LPAE/artigos/eolico_2024/Peças 3D/Engrenagem_Grande.stl

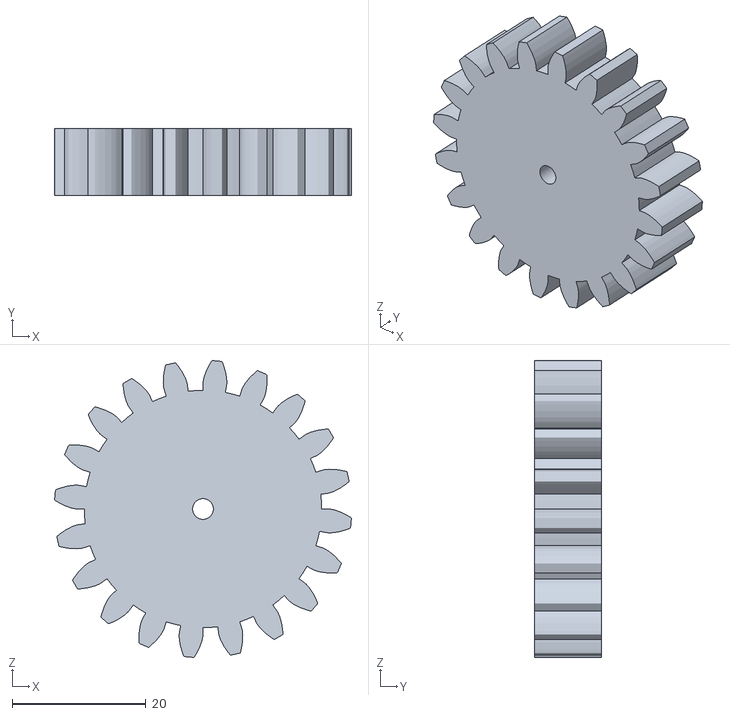
[picture p16: CAD file, 2024-05-15]
eolico_2024/Peças 3D/Engrenagem_Grande.stl
44.4 x 10.0 x 44.4
