LPAE/artigos/eolico_2024/Peças 3D/Peças Modificadas/BaseOca3.2.stl

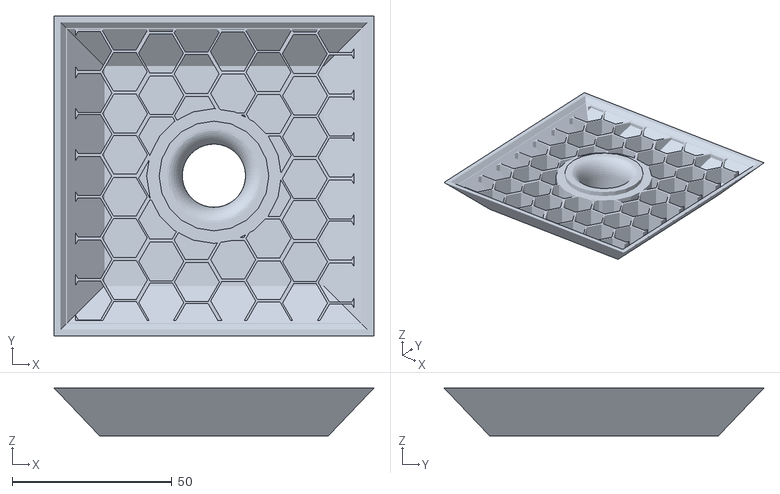
[picture p17: CAD file, 2024-05-15]
eolico_2024/Peças 3D/Peças Modificadas/BaseOca3.2.stl
100.0 x 100.0 x 15.0
