LPAE/artigos/eolico_2024/Peças 3D/Peças Modificadas/BaseSolida2.0.stl

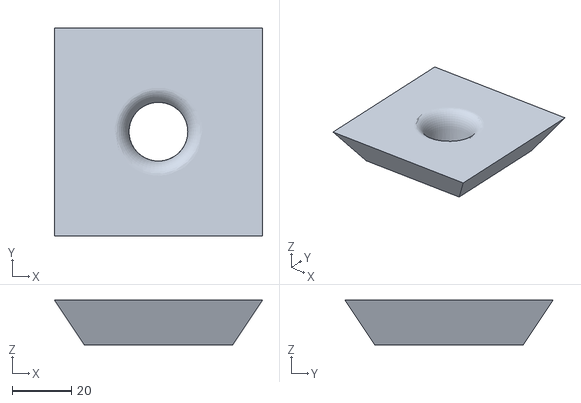
[picture p18: CAD file, 2024-05-15]
eolico_2024/Peças 3D/Peças Modificadas/BaseSolida2.0.stl
70.0 x 70.0 x 15.0
