LPAE/artigos/eolico_2024/Peças 3D/Suporte_Motor.stl

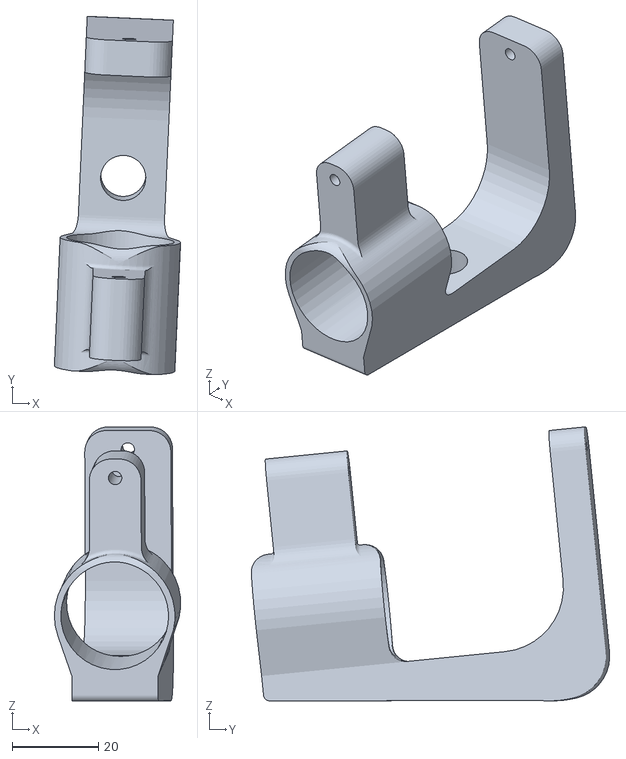
[picture p19: CAD file, 2024-05-15]
eolico_2024/Peças 3D/Suporte_Motor.stl
29.3 x 83.1 x 63.5
