LPAE/artigos/eolico_2024/Peças 3D/Engrenagem_Pequena.stl

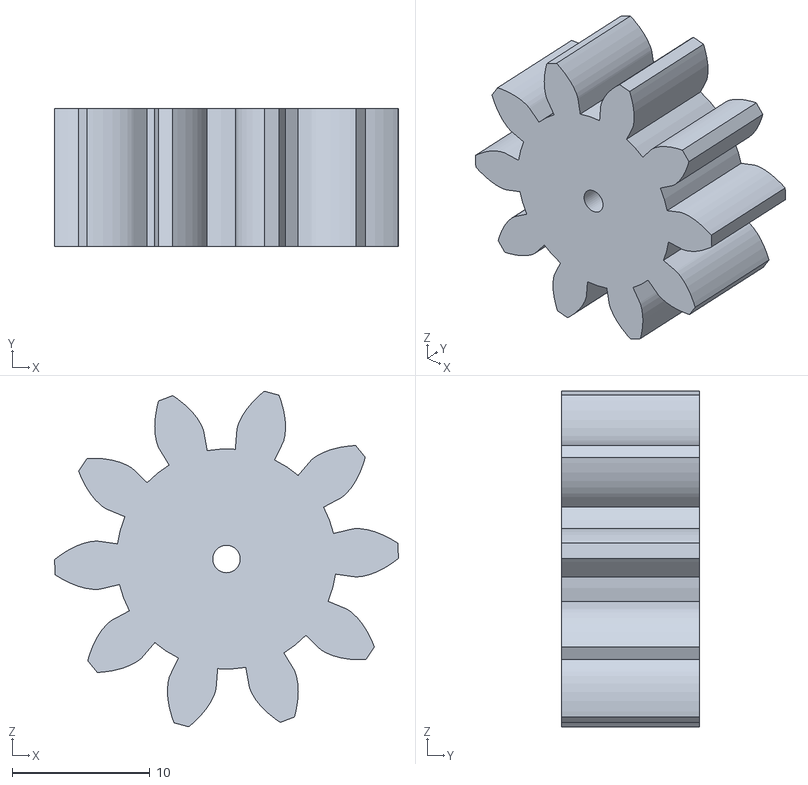
[picture p20: CAD file, 2024-05-15]
eolico_2024/Peças 3D/Engrenagem_Pequena.stl
25.0 x 10.0 x 24.4
