LPAE/artigos/eolico_2024/Peças 3D/Peças Modificadas/Turbinia3.2.stl

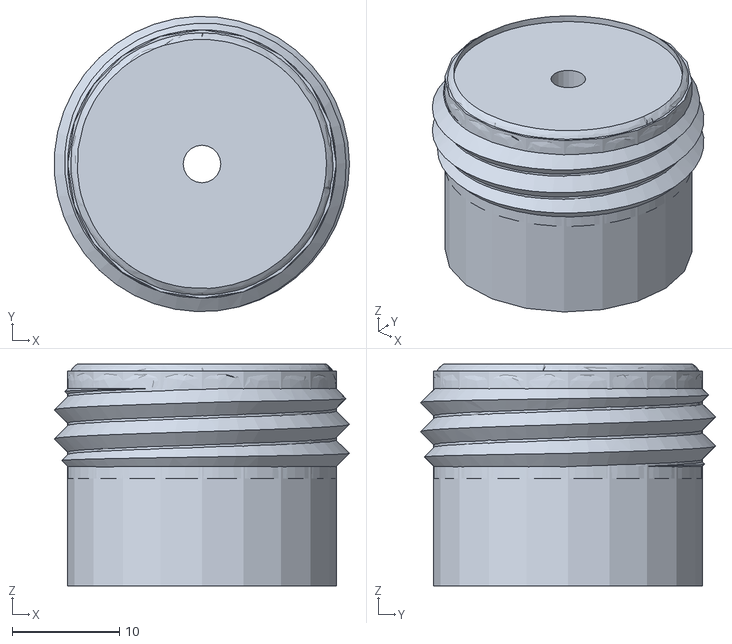
[picture p21: CAD file, 2024-05-15]
eolico_2024/Peças 3D/Peças Modificadas/Turbinia3.2.stl
27.5 x 27.5 x 20.7
