LPAE/artigos/eolico_2024/Peças 3D/Suporte_Helices.stl

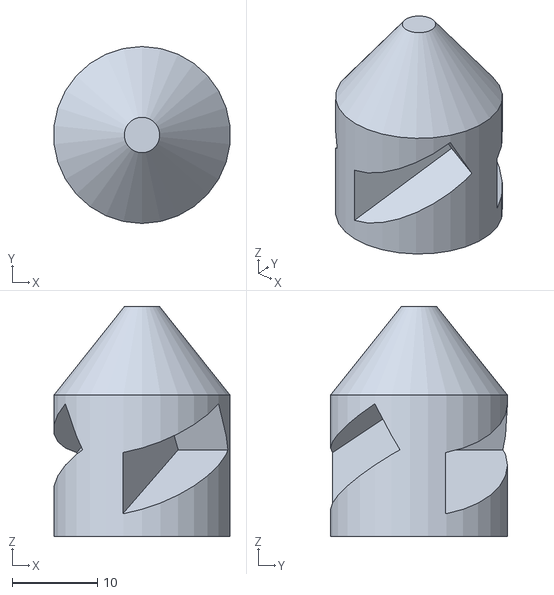
[picture p23: CAD file, 2024-05-15]
eolico_2024/Peças 3D/Suporte_Helices.stl
20.7 x 20.8 x 27.0
