LPAE/artigos/eolico_2024/Peças 3D/Base.stl

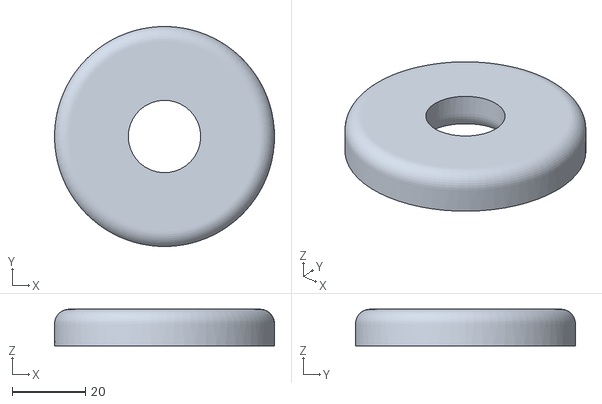
[picture p24: CAD file, 2024-05-15]
eolico_2024/Peças 3D/Base.stl
60.0 x 60.0 x 10.0
