LPAE/artigos/eolico_2024/Peças 3D/Peças Modificadas/BaseSolida1.0.stl

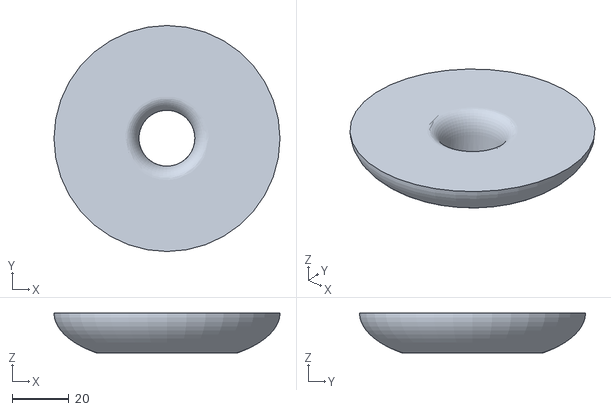
[picture p25: CAD file, 2024-05-15]
eolico_2024/Peças 3D/Peças Modificadas/BaseSolida1.0.stl
80.0 x 80.0 x 14.0
