LPAE/artigos/eolico_2024/Peças 3D/Suporte_Estrutura.stl

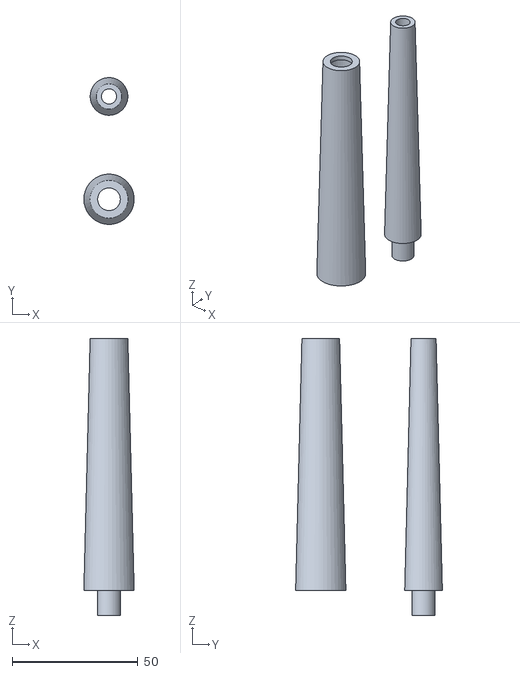
[picture p27: CAD file, 2024-05-15]
eolico_2024/Peças 3D/Suporte_Estrutura.stl
20.0 x 58.3 x 110.0
