LPAE/artigos/eolico_2024/Peças 3D/Helice.stl

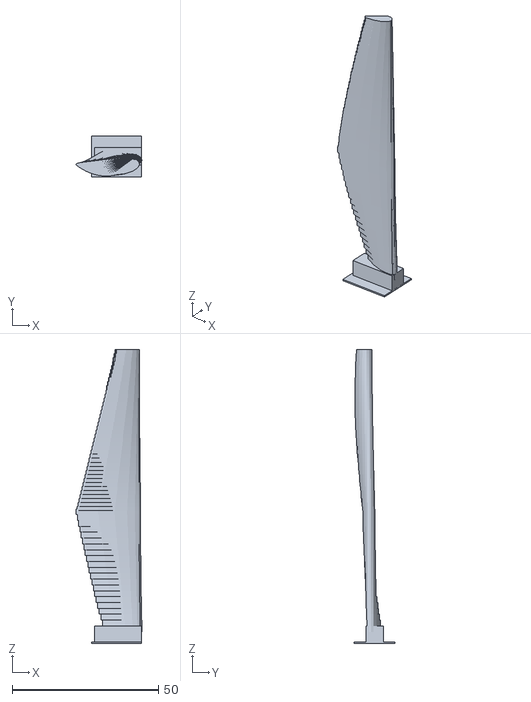
[picture p28: CAD file, 2024-05-15]
eolico_2024/Peças 3D/Helice.stl
22.5 x 14.0 x 100.4
