LPAE/artigos/eolico_2024/Peças 3D/Engrenagem_Grande_2.stl

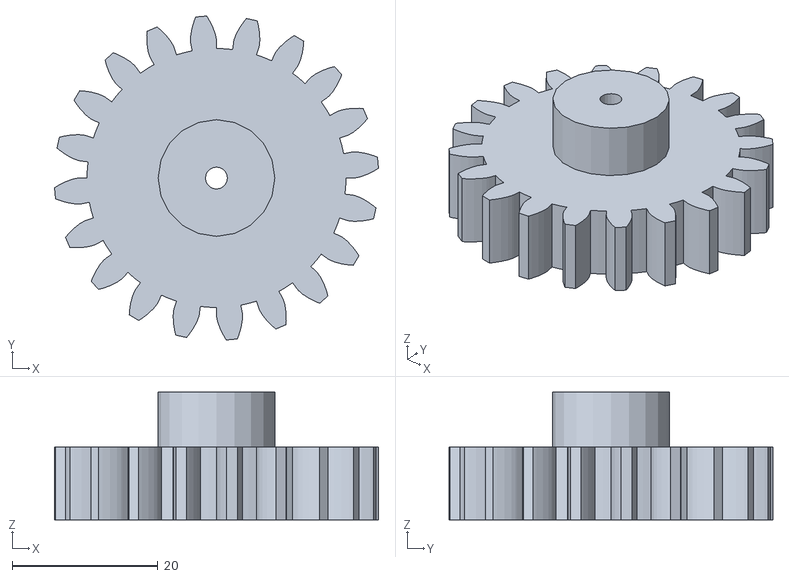
[picture p29: CAD file, 2024-05-15]
eolico_2024/Peças 3D/Engrenagem_Grande_2.stl
44.4 x 44.4 x 17.5
