LPAE/artigos/eolico_2024/Projeto Kicad/Geracao_Eolica/teste.kicad_pcb

## KiCad design eolico_2024/Projeto Kicad/Geracao_Eolica/teste.kicad_pcb (2024-05-15)

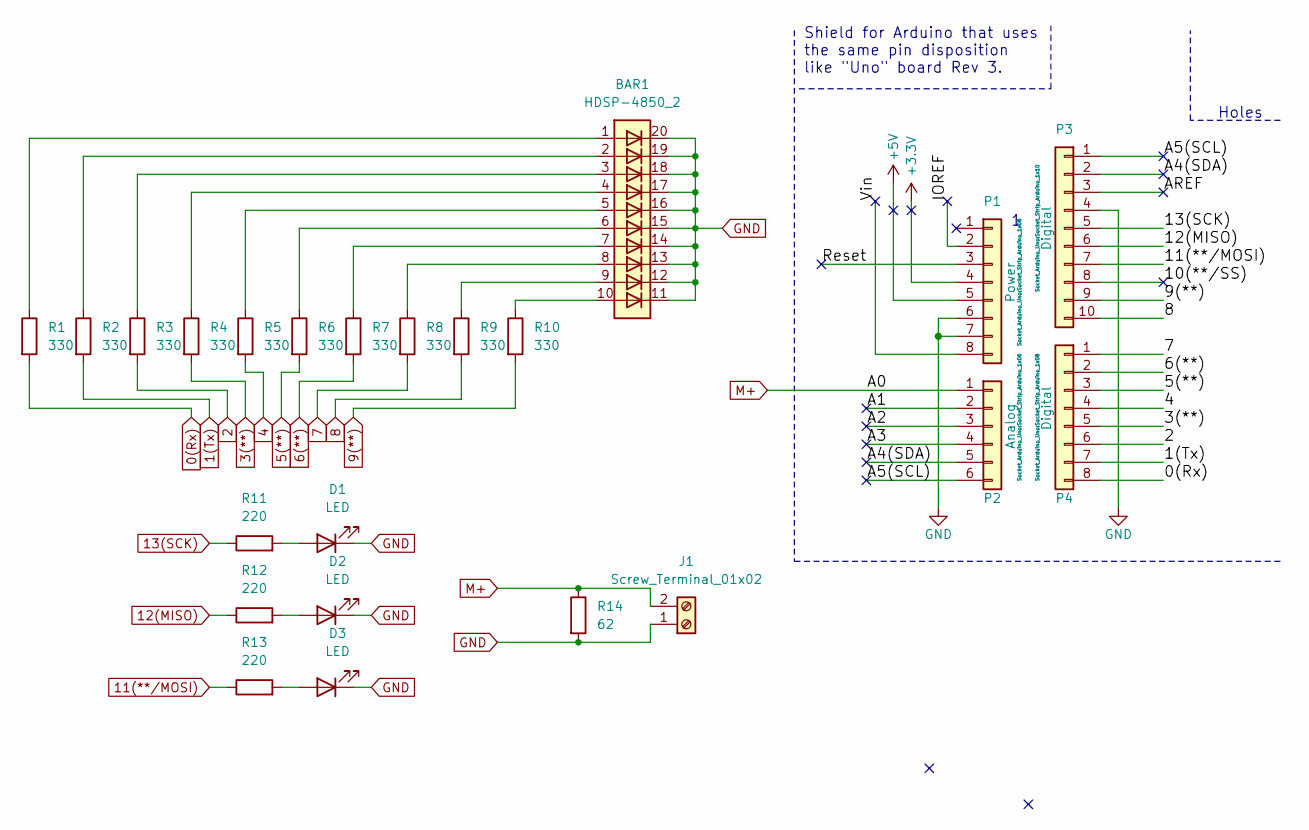
[picture p30: schematic teste.kicad_sch, Geração Eólica IFSC - IEE]

Parts:
BAR1: HDSP-4850_2; HDSP-4850
D1, D2, D3: LED; LED_D3.0mm
J1: Screw_Terminal_01x02; TerminalBlock_Phoenix_MKDS-1,5-2_1x02_P5.00mm_Horizontal
P1: Power; Socket_Strip_Arduino_1x08
P2: Analog; Socket_Strip_Arduino_1x06
P3: Digital; Socket_Strip_Arduino_1x10
P4: Digital; Socket_Strip_Arduino_1x08
R1, R2, R3, R4, R5, R6, R7, R8, R9, R10: 330; R_Axial_DIN0207_L6.3mm_D2.5mm_P10.16mm_Horizontal
R11, R12, R13: 220; R_Axial_DIN0207_L6.3mm_D2.5mm_P10.16mm_Horizontal
R14: 62; R_Axial_DIN0204_L3.6mm_D1.6mm_P7.62mm_Horizontal

Connections:
0(Rx): P4.8, R1.2
1(Tx): P4.7, R2.2
2: P4.6, R3.2
3(**): P4.5, R4.2
4: P4.4, R5.2
5(**): P4.3, R6.2
6(**): P4.2, R7.2
7: P4.1, R8.2
8: P3.10, R9.2
9(**): P3.9, R10.2
11(**/MOSI): P3.7, R13.1
12(MISO): P3.6, R12.1
13(SCK): P3.5, R11.1
+3V3: P1.4
+5V: P1.5
/10(**/SS): P3.8
/A1: P2.2
/A2: P2.3
/A3: P2.4
/A4(SDA): P2.5, P3.2
/A5(SCL): P2.6, P3.1
/AREF: P3.3
/IOREF: P1.2
/Reset: P1.3
/Vin: P1.8
GND: BAR1.11 (K), BAR1.12 (K), BAR1.13 (K), BAR1.14 (K), BAR1.15 (K), BAR1.16 (K), BAR1.17 (K), BAR1.18 (K), BAR1.19 (K), BAR1.20 (K), D1.1 (K), D2.1 (K), D3.1 (K), J1.1, P1.6, P1.7, P3.4, R14.2
M+: J1.2, P2.1, R14.1
unnamed: BAR1.1 (A), R1.1
unnamed: BAR1.2 (A), R2.1
unnamed: BAR1.3 (A), R3.1
unnamed: BAR1.4 (A), R4.1
unnamed: BAR1.5 (A), R5.1
unnamed: BAR1.6 (A), R6.1
unnamed: BAR1.7 (A), R7.1
unnamed: BAR1.8 (A), R8.1
unnamed: BAR1.9 (A), R9.1
unnamed: BAR1.10 (A), R10.1
unnamed: D1.2 (A), R11.2
unnamed: D2.2 (A), R12.2
unnamed: D3.2 (A), R13.2

Notes on the sheet:
Holes
Shield for Arduino that uses the same pin disposition like "Uno" board Rev 3.

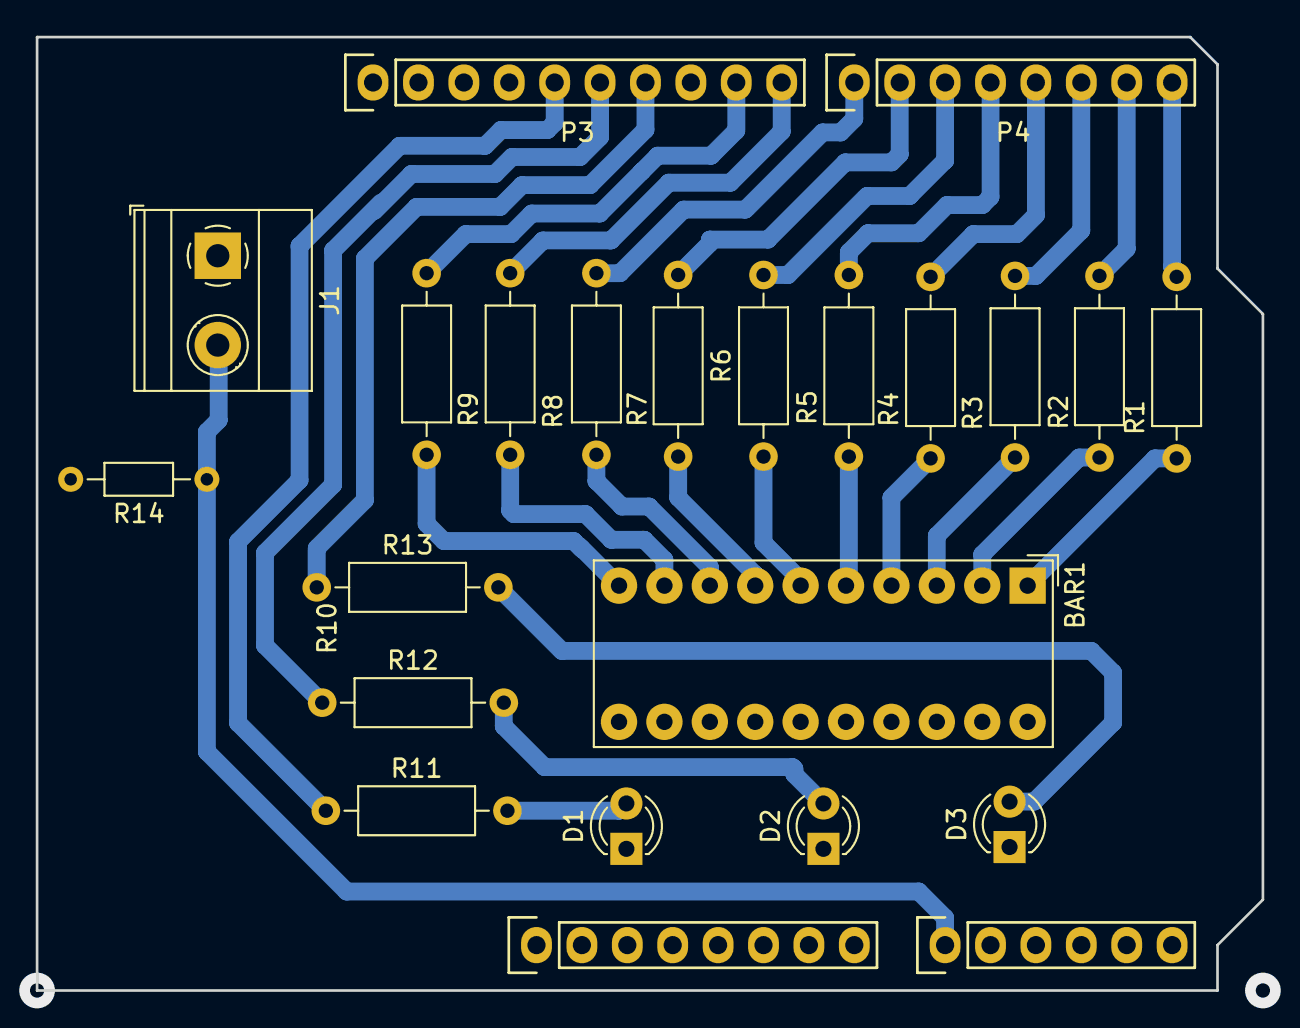
[picture p31: board teste.kicad_pcb from above]

Board: 2 copper layers, 68.6 x 53.3 mm, 23 parts (0 on the bottom side), 30 nets.
